EECS581Team15/WifiLMR/docs/basics/Glossary.md

Glossary
========

Acronyms
--------

* LMR - Land Mobile Radio
* PTT - Push-to-talk
* UI - User Interface

Terms
-----

* Subscriber Unit - The end user device (a.k.a. "radio" in common practice)
