EECS581Team15/WifiLMR/(threads)

Thread 2 (2018-10-08):

UI design

zjcers, 2018-10-08:
* Create mock ups for the various user interface screens.
   Make some pictures in Photoshop or GIMP as reference for when we're implementing the UI.
* Document user work flows
   Diagrams for how a user uses the UI (ex: for this task, press <button> to reach this screen, or select the given menu item)

jackdweber, 2018-10-17:
UI Designs needed
* Main Screen
* Settings / Applications screen
    * Possible theming
    * WiFi Selection?
    * Volumes
    * More to come
* Channel selection
* Messaging Screen
    * Messaging Detail Screen

zjcers, 2018-10-18:
Volume and channel selection will have hardware controls. We'll probably want a selection screen for channels either way, though. Might want a nice display slider to pop up when adjusting volume, too.

I think "zones" (groups of channels) were in the spec, so we'll probably want a list screen for that, too.

zjcers, 2018-10-22:
Note: the screen we selected has a resolution of 160x128.

AstralA, 2018-10-29:
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 Main Screen
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 Setting Screen
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 Channel Screen
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 Messages Screen
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 Zones Screen
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 User Workflow

Closed 2018-10-29.

Thread 3 (2018-10-08):

UI MVP

zjcers, 2018-10-08:
Implementation of the UI from #2. The implementation definitely needs to run on ARM GNU/Linux, but it would be really nice if the chosen toolkit library supports multiple platforms. It also needs to be .NET Core compatible because of our implementation choices. From these constraints, I recommend GTK#. It runs on Linux, Windows, and OS X (I believe). There's also a lot of examples for it. The only problem that see is that it rather heavy, but no more so than Qt.

zjcers, 2018-10-11:
@johnying7 You might want to look at this.

jackdweber, 2018-10-29:
see branch initial_ui

Thread 4 (2018-10-09):

Select initial hardware

zjcers, 2018-10-09:
* System on Module - [Raspberry Pi Zero W](https://www.adafruit.com/product/3400)
* Screen - [1.8 TFT ](https://www.adafruit.com/product/358)
* d-pad - either something pre-made or make a small PCB with push buttons (or https://www.adafruit.com/product/504)
* some sort of RGB led and driver circuit (could be an AVR like the ATtiny4313 driving PWMs)
* Battery
* Fuel guage/charging circuit

zjcers, 2018-10-28:
https://docs.google.com/spreadsheets/d/1XvdMbyRwS1jhkPt34Vz_26SZia36OKx0R4IcnpCc9fw/edit?usp=sharing

Closed 2018-10-28.

Thread 6 (2018-10-14):

Design HAL Interfaces

zjcers, 2018-10-14:
To facilitate development, we need to have a hardware abstraction layer that allows switching between interfacing with real hardware and simulated hardware. This will also ensure the hardware implementation details don't sink into unrelated components, like the UI.

zjcers, 2018-11-23:
HAL Interfaces:
* Backlight
   - set_level(lvl) (sets level to lvl, a value in [0, 100])
   - off() (sets level to 0 and saves previous)
   - on() (sets level to previous)
* Battery
   - get_level() (gets an estimated percentage in [0, 100])
   - is_charging() (returns True if the battery is charging)
* WiFi
   - scan() (returns a list of base stations in range)
   - connect(name, auth_data=None) (connect to a network)
   - status() (returns signal strength and other data)

zjcers, 2018-11-23:
This is probably good enough for now. I'll leave this open for a while for additional discussion.

zjcers, 2019-02-05:
After some more thought on this, it'd probably be simpler for wifi to just accept wpa_supplicant config files. This way we don't have to really worry too much about wifi, we can just let wpa_supplicant do all of the smart stuff.

We should probably think about providing a mechanism for rolling back a failed wifi config update ()

Closed 2019-04-22.

Thread 7 (2018-10-14):

Implement Dummy HAL

zjcers, 2018-10-14:
This HAL implementation will simulate (in a "best effort" sort of way) the actual hardware components of the radio. The biggest focus is on input and output, as the UI is the largest component we will have to build ourselves.

zjcers, 2018-10-14:
blocked by #6

zjcers, 2018-10-14:
Input and output can be implemented using standard Linux things:
Input: https://www.kernel.org/doc/Documentation/devicetree/bindings/input/gpio-keys.txt
Output: SPI framebuffer + http://www.microwindows.org/ to allow the use of "X11"

zjcers, 2018-11-23:
This is no longer blocked by #6 and is ready to be implemented.

zjcers, 2019-02-27:
The backlight implementation was done so that this isn't needed. I'd imaging wifi and battery will follow suit, so this issue is obsolete.

Closed 2019-02-27.

Thread 8 (2018-10-14):

Power switch circuit

zjcers, 2018-10-14:
Design constraints:
* Minimize power draw when device is off
* Allow soft power down (warn the OS rather than just cutting power)
* Minimize components

zjcers, 2018-10-15:
I've been looking into the RUN pin on the RPi (aka BCM2835 RESET). This looked viable, but the power draw in halt mode (this pin does not full shutdown the board) is rather high (15-30ma for the RPi alone). The simplest thing to do is control the main power supply through a MOSFET and build some logic so that the OS must acknowledge the shutdown request before power is cut.

I considered debouncing the power switch with a RC low pass filter plus a Schmitt trigger buffer. While that circuit is pretty simple, we need to handle the soft shutdown case as well. That is doable by using a Schmitt trigger input quad NOR gate. The buffer of the debouncer would be one half of an SR latch. This leaves the other half of the chip free to be used for handling the shutdown input (R for the latch). Unfortunately, there isn't a good way to tell that the RPi has finished its shutdown sequence. The only option is monitoring TXD, which would need buffered (to not corrupt the serial output) and debounced. Additionally, TXD is low at start up, its input should only take effect after the debounced power switch input goes low. This is solvable (I have schematic sketched in my notebook). On the other hand, there's a cheaper, easier solution: a very small microcontroller.

I believe the best option for this is the ATtiny4313. I considered using something really small, like the ATtiny9 (which is physically very, very small), but for a dime more, the 4313 offers enough PWM to implement not only power sequencing, but control of the RGB status LED. The ATtiny214 would have been an excellent choice, except there's not a whole lot of development resources on it right now (since it seems to be an AVR with some PIC peripherals glued on). Also, I have some 4313s on hand already.

With 3 channels of PWM in play + a timer driving the debounce routines, the implementation will be a little goofy. The 4313 has two timers: 1 8-bit timer and 1 16-bit timer. The 8-bit one will be setup to run PWM on both compare channels. The 16-bit timer will run PWM on one channel and drive the douncer ISR off of the other. Both will run at the PWM frequency. The PWM outputs will be exposed over I2C as 16-bit words of (output, level). The actual PWM functionality will not be implemented as part of this ticket.

zjcers, 2018-12-03:
The microcontroller was dropped completely. I also managed to get away with removing any sequential logic by replacing the power button with a switch.

I'm leaving this ticket open until the design is actually verified.

zjcers, 2019-03-21:
Cannot verify this until #16 is implemented.

Thread 10 (2018-10-15):

Screen hardware implementation - development board

zjcers, 2018-10-15:
Screen (Adafruit): https://www.adafruit.com/product/618

For the initial development, this will likely follow the tutorials listed on Adafruit. Since using the parallel interface would consume almost all available pins on the RPi, we'll have to use SPI. This will be somewhat less performant, but should be fine.

zjcers, 2019-02-13:
I've got this mostly working, but activating rotation (screen defaults to portrait) seems to break things. I need to investigate further. Changes will end up in #47

zjcers, 2019-02-16:
This is awaiting review

zjcers, 2019-02-21:
Closed by #47

Closed 2019-02-21.

Thread 9 (2018-10-15):

Platform Controller Firmware Implementation

zjcers, 2018-10-15:
As discussed in #8, the simplest way to implement the power switch will be to use a small microcontroller. The part is an ATtiny2313 or ATtiny4313, depending on code size (likely the 2313 will be sufficient). As discussed in #8, this controller should perform the following duties:
* Power switch debouncing
* Power on, power off sequencing - soft power down (don't cut main power until the main processor halts)
* PWM output to the RGB status LED

Note: I was considering using an ADC on this controller to read the volume potentiometer. There isn't a great reason to do this in our case (though it would give us more control). The 4313 doesn't have an ADC, so this isn't happening.

zjcers, 2018-12-04:
This ticket is now obsolete since the design now omits the platform controller

Closed 2018-12-04.

Thread 13 (2018-10-18):

Write a device tree overlay for D-pad input

zjcers, 2018-10-18:
The Linux kernel has a nice driver for mapping raw GPIOs into a keyboard-like device: https://www.kernel.org/doc/Documentation/devicetree/bindings/input/gpio-keys.txt. Our D-pad will have 5 inputs: KEY_UP, KEY_DOWN, KEY_LEFT, KEY_RIGHT, KEY_ENTER. These have pretty obvious mappings to normal Linux keys. There's also built-in debouncing, so we don't need to implement that either.

jackdweber, 2018-10-25:
http://blog.gegg.us/2017/01/setting-up-a-gpio-button-keyboard-on-a-raspberry-pi/

Obviously blocked until we have the device.

zjcers, 2019-03-21:
I've got this all but done in a local branch.

Closed 2019-04-22.

Thread 16 (2018-10-18):

Configure gpio-poweroff

zjcers, 2018-10-18:
The Linux kernel has a mechanism for triggering power down from a GPIO. In fact, the RPi kernel has a builtin dtoverlay for this: https://github.com/raspberrypi/linux/issues/1802. This is blocked by #8 and #9.

zjcers, 2019-03-21:
Blocked on #80

Thread 18 (2018-10-18):

BSP build system

zjcers, 2018-10-18:
The Board Support Package includes the kernel, bootloader, and root filesystem (which includes our application). There should be a relatively pain-free way to take our board support modifications along with our RadioApp and provisions to boot into it. The RPi already boots from SD cards, so "flashing" a unit should be relatively simple, though doing so on Windows will require some sort of raw image writing application.

zjcers, 2018-10-25:
Buildroot already has a working configuration for the RPi Zero W, so this shouldn't take long. On the other hand, I can't reasonably test this without real hardware, so I'm tabling this until we get hardware.

zjcers, 2018-11-23:
Going to introduce a branch with Buildroot set up. Since development hardware still isn't assembled (but will be soon), this will be a work in progress for a little while

Closed 2019-02-05.

Thread 23 (2018-10-26):

Acquire development hardware

zjcers, 2018-10-26:
Need to get:
 * Raspberry Pis (going to try to order all 10 of them)
 * Audio Hardware
   - Amplifier (digital) (breakout)
   - Microphone (digital) (breakout)
   - Speaker
 * Screen breakout
 * User controls
   - Navigation/D-pad
   - PTT
   - Channel knob
   - Volume knob
 * Power supply components (so far)
   - Power sequencer (ATtiny9)
   - Standby power supply (linear regulator 3.3v)
   - SOT23 breakout boards for ATtiny & regulator
   - MOSFET to cut main power
 * Solder breadboard to make prototypes semi-permanent

## Notes:
 * Only order 2 each of breakout boards and parts that aren't certain yet (speaker, switches)

zjcers, 2018-10-26:
There is an order summary in Gdrive under PartsOrders

zjcers, 2018-10-26:
Order submitted to Dr. Johnson for approval.

zjcers, 2018-11-23:
First order received and assembly underway. Will need to file a second order now that the schematic is done.

Closed 2018-11-23.

Thread 32 (2018-11-18):

Convert the UI to use keyboard input

zjcers, 2018-11-18:
The UI MVP uses mouse input for button presses. As we will not have a mouse or any other sort of pointing device, we need to convert it use keyboard navigation. Specifically, there will be five keys: up, down, right, left, and enter. This dictates that there will be a `current` selected control. This control should be highlighted in some way and pressing enter should activate it.

zjcers, 2018-12-04:
tkinter already supports Tab and Shift+Tab for navigation and Space for activating controls. We can map the left, right, and select keys to those event types and this should mostly work. One thing I noticed is that widgets that are from the previous screen are still accessible. This is another issue that should be addressed anyway.

zjcers, 2019-03-07:
Stealing this.

Closed 2019-03-09.

Thread 33 (2018-11-18):

Initial mechanical design

zjcers, 2018-11-18:
A rough version of the casing of the device along with its buttons should be created. A good deal of the internal structure can be started as well such as the mounts for the speaker and back cover. The battery holder can be started once a battery is selected so long as the placement does not depend on the layout of the expansion PCB. Since the expansion PCB is not completed yet, the mounting points for it may not be possible.

zjcers, 2018-12-04:
I've had this mostly completed for a while. It's missing the mounting points for the PCB (which are now known as the initial layout is nearly complete).

zjcers, 2019-02-05:
I'm going to put up a PR for this. It's not perfect (it's missing the top controls and the PCB standoffs are all wrong) but that way it makes it into source control

Closed 2019-03-16.

Thread 34 (2018-11-18):

Provisioning mode UI

zjcers, 2018-11-18:
The provision mode flow is documented in docs/features/ProvisioningMode.md. As of right now, this document is out of date if we're aiming to use WiFi Protected Setup, though we may want to revisit that issue seeing as though most enterprise WiFi deployments do not support WPS. As such, the ticket is pending that discussion.

Thread 50 (2019-02-13):

Battery gauge should be an icon

zjcers, 2019-02-13:
The battery meter should be an icon that "fills up" with charge, like on most phones/portable devices.  Extra points if it changes color at certain percentages (say, red at < 20%, orange at < 40%, green otherwise).

zjcers, 2019-03-07:
Since tkinter makes it hard to draw redraw graphics, how about an outlined rectangle with a colored background (which turns red on low battery) with the percentage text centered inside of it?

AstralA, 2019-03-07:
Yes, I'm trying to build it that way.

Closed 2019-04-05.

Thread 51 (2019-02-13):

Bottom buttons should have images for labels

zjcers, 2019-02-13:
Right now the on-screen buttons have the numbers 1, 2, and 3 for labels. These should be replaced with icons, like in @jackdweber 's UI mock up.

Closed 2019-03-16.

Thread 52 (2019-02-13):

Main Menu UI

zjcers, 2019-02-13:
Since we're going to have more screens than can fit on the 3 main screen buttons, we need some sort of menu in which less-frequently used items can be accessed. This can either be a simple list of items (a ListView in most UI paradigms) or an array of icons (like most flip phones).

Thread 59 (2019-02-13):

Low-level backlight support

zjcers, 2019-02-13:
In order for the backlight UI to have effect we need to:
- [x] Map the backlight PWM in device tree
- [x] Expose the PWM device through the HAL
- [x] Hook the UI up to the HAL

zjcers, 2019-02-27:
Pending review

Closed 2019-03-07.

Thread 71 (2019-03-14):

Reconfigure display driver for PCB use

zjcers, 2019-03-14:
The PCB design doesn't match the default mapping the display driver assumes. The correct mapping is:
* LCD_RESET -> GPIO24
* LCD_DC -> GPIO7
* LCD_CS -> GPIO8
* BKLIGHT -> GPIO12 (already mapped)

Closed 2019-03-16.

Thread 73 (2019-03-16):

RPi connector is backwards

zjcers, 2019-03-16:
The PCB layout originally had the RPi connector (J5) on the other edge of the board. When it got moved, it should have been rotated 180 degrees to compensate. Currently, the RPi sticks out from behind the main board rather than being tucked behind as intended.

Thread 74 (2019-03-16):

Screen connector is backwards

zjcers, 2019-03-16:
This is similar to #73. The screen footprint needs to be rotated 180 degrees so that the screen pinout matches up correctly. This will require moving the pads from the left edge to the right edge as well (but there's plenty of extra space available).

zjcers, 2019-04-04:
Correction: It was not 180 degrees, it was due to the footprint having the pads on the wrong side of the board. It can still be fixed by rotating 180 degrees, though the layout might be nicer if the actual footprint is fixed (otherwise the screen connector ends up very close to J5).

Thread 75 (2019-03-16):

Audio amplifier layout is wrong

zjcers, 2019-03-16:
The following corrections should be made to make the device function:
* GAIN_SLOT should be connected with a 100k resistor to Vcc (to set gain at 3dB to avoid overloading the power supply)
* The NC pads should actually be no-connects. Duh.

Currently the device outputs a somewhat modulated PWM signal (mostly correct) but the gain is set so stupidly high (12 dB) that the output just clips pretty much constantly.

zjcers, 2019-03-21:
Strictly speaking, this wasn't just a layout issue since the schematic was wrong as well.

Thread 76 (2019-03-16):

Charging connector is missing

zjcers, 2019-03-16:
The first revision of the PCB is conspicuously missing a way to apply power. As a workaround, I've been supplying power via test points on the RPi.

Thread 77 (2019-03-16):

Audio driver support

zjcers, 2019-03-16:
Need to map the MAX98357A I2S DAC/amp and the SPH0645LM4H I2S microphone. The main constraint is that the microphone needs BLCK=LRCLK/64. Luckily, the DAC is more flexible, so the two can coexist. Unfortunately, this will require a custom device tree overlay (as opposed to invoking one of the premade ones).

zjcers, 2019-03-21:
Using a combination of `simple-audio-card` and the standard SPDIF drivers, I was able to get the amplifier to work. As far as I can tell, the SPDIF codec drivers don't support 32-bit sampling (required by the microphone), so a custom codec driver will need to be implemented.

Closed 2019-04-22.

Thread 78 (2019-03-18):

I2C lines on J5 are reversed

zjcers, 2019-03-18:
I don't know how this got managed, but SCL is connected to SDA and vice-versa.

zjcers, 2019-03-21:
This was a transposition on the schematic.

Thread 80 (2019-03-21):

Shutdown/reboot is broken

zjcers, 2019-03-21:
The current kernel configuration fails to halt the system with something along the lines of "Failed to reboot; halting system"

Thread 83 (2019-03-27):

Mechanical design v2

zjcers, 2019-03-27:
**Bugs in v1**
- [x] Walls were thicker than necessary
- [x] Buttons were too close together (skirts conflicted with each other)

**Missing features in v1**
- [x] Mounts for PTT button
- [x] Mounts & cut outs for knobs & encoders
- [x] Version label on inside of front
- [x] Mounts for speaker
- [x] Internal stabilizers for screen
- [ ] Mounts for rear cover

**Design changes since v1**
- [x] PCB mounts have changed
- [x] Can be narrower
- [x] Mounting screws can go straight into plastic rather than using the thermal insets

Closed 2019-04-04.

Thread 88 (2019-04-10):

Op-amp U2 not driven into saturation

zjcers, 2019-04-10:
Since the inputs to U2 (BATT+ and +5V) are higher than its Vcc, it is not driven into saturation. Kludging voltage dividers (100k/10k) onto the inputs fixed this.

Thread 89 (2019-04-10):

Mechanical design v4

zjcers, 2019-04-10:
The v3 casing is mostly okay except for the following issues:

- [x] Not wide enough to fit battery in
- [x] Side PTT will not be used
- [x] Knobs should have skirts
- [x] Button holes need to shrink by 0.1 mm (center) and 0.075mm (others)

Closed 2019-04-22.

Thread 90 (2019-04-17):

Microphone (U9) footprint is backwards

zjcers, 2019-04-17:
Needs flipped over the long axis of the part.
