EECS581Team15/WifiLMR/hardware/electronic/LMRHAT.kicad_pcb

## KiCad design hardware/electronic/LMRHAT.kicad_pcb (2019-02-05)

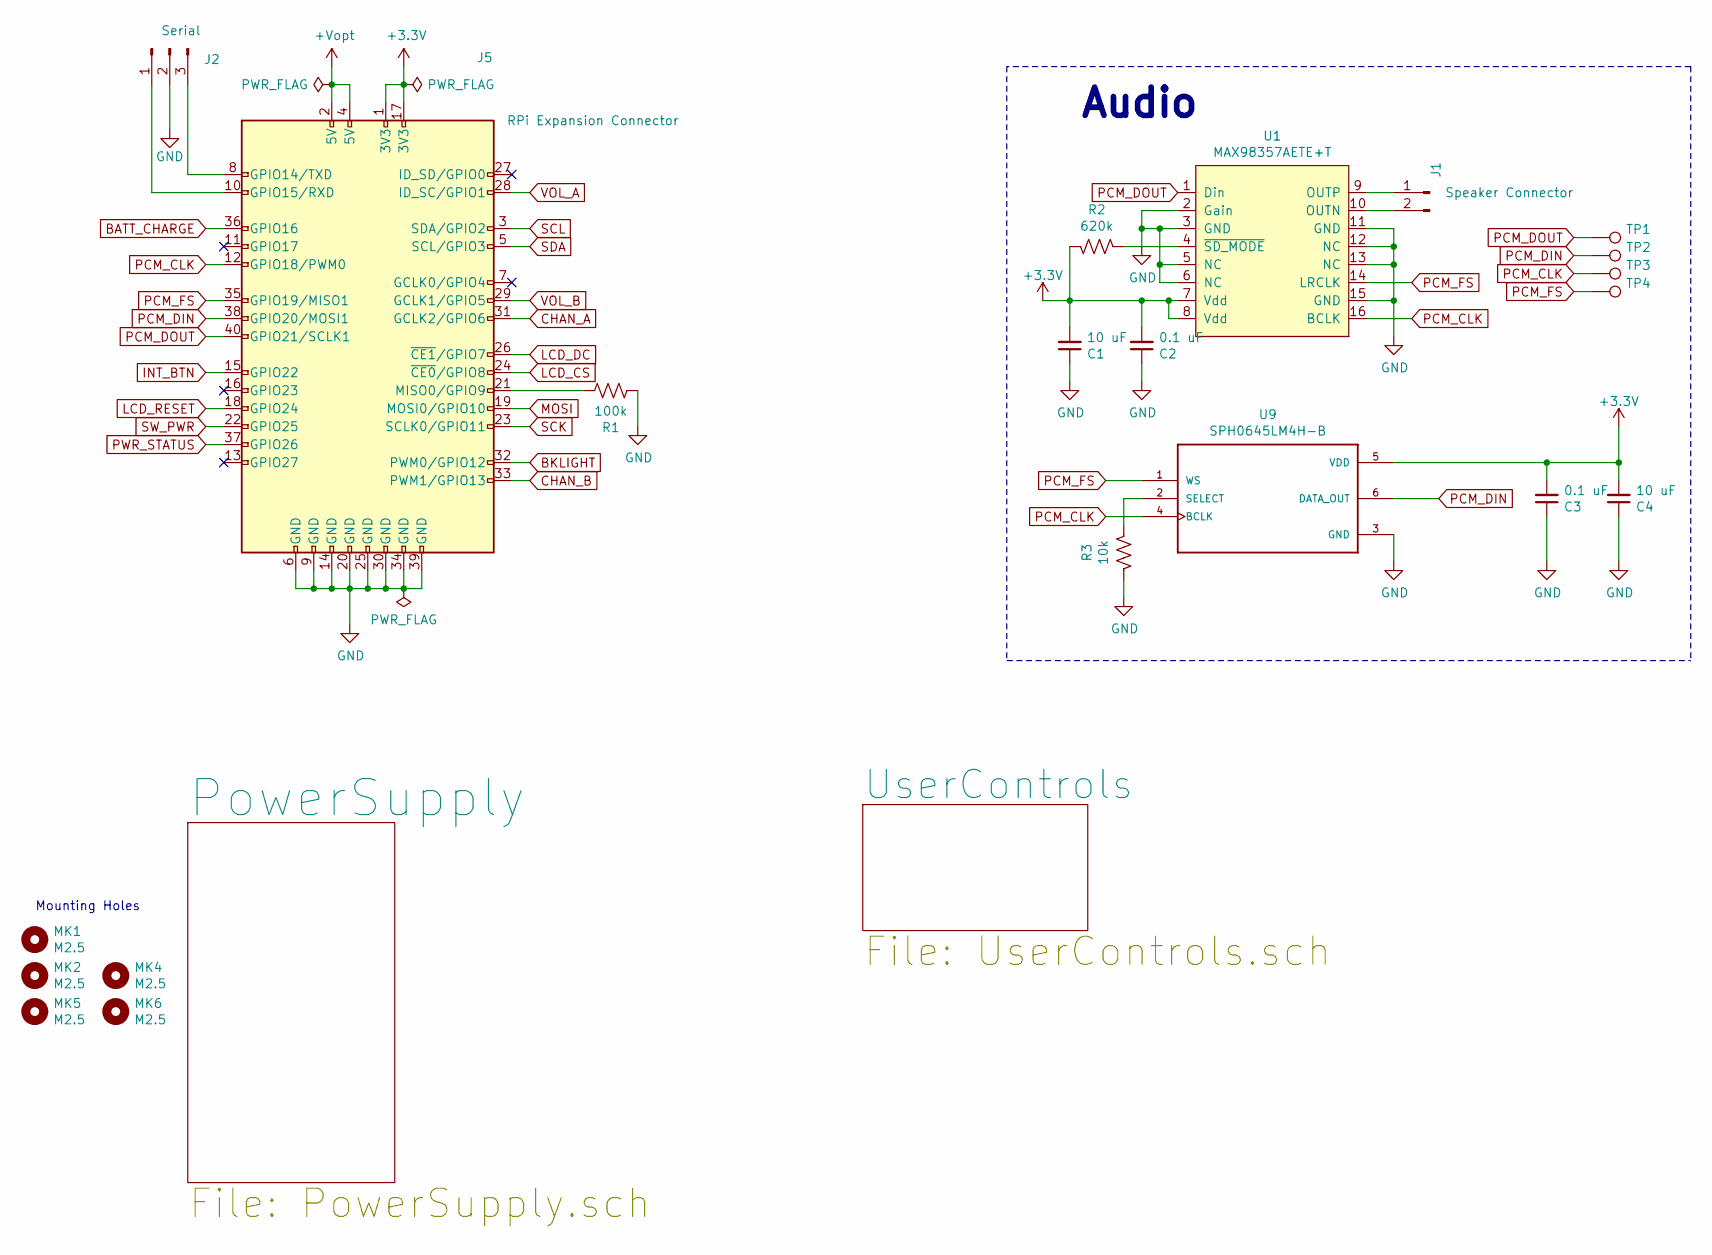
[picture p1: schematic LMRHAT.sch]

Parts:
C1, C4: 10 uF; C_1206_3216Metric_Pad1.42x1.75mm_HandSolder
C2, C3: 0.1 uF; C_1206_3216Metric_Pad1.42x1.75mm_HandSolder
J1: Speaker Connector; JST_EH_B02B-EH-A_1x02_P2.50mm_Vertical
J2: Serial; PinSocket_1x03_P2.54mm_Vertical
J5: RPi Expansion Connector; PinSocket_2x20_P2.54mm_Vertical_SMD
MK1, MK2, MK4, MK5, MK6: M2.5; MountingHole_2.7mm_M2.5
R1: 100k; R_1206_3216Metric_Pad1.42x1.75mm_HandSolder
R2: 620k; R_1206_3216Metric_Pad1.42x1.75mm_HandSolder
R3: 10k; R_1206_3216Metric_Pad1.42x1.75mm_HandSolder
TP1, TP2, TP3, TP4: TestPoint_Pad_D1.0mm
U1: MAX98357AETE+T; QFN-16-1EP_3x3mm_P0.5mm_EP1.8x1.8mm
U9: SPH0645LM4H-B; MIC_SPH0645LM4H-B

Connections:
+3V3: C1.2, C2.2, C3.2, C4.2, J5.1 (3V3), J5.17 (3V3), R2.1, U1.7 (Vdd), U1.8 (Vdd), U9.5 (VDD); also elsewhere on the board
+5V: J5.2 (5V), J5.4 (5V); also elsewhere on the board
BATT_CHARGE: J5.36 (GPIO16); also elsewhere on the board
BKLIGHT: J5.32 (PWM0/GPIO12); also elsewhere on the board
CHAN_A: J5.31 (GCLK2/GPIO6); also elsewhere on the board
CHAN_B: J5.33 (PWM1/GPIO13); also elsewhere on the board
INT_BTN: J5.15 (GPIO22); also elsewhere on the board
LCD_CS: J5.24 (~CE0~/GPIO8); also elsewhere on the board
LCD_DC: J5.26 (~CE1~/GPIO7); also elsewhere on the board
LCD_RESET: J5.18 (GPIO24); also elsewhere on the board
MOSI: J5.19 (MOSI0/GPIO10); also elsewhere on the board
unnamed: J1.1, U1.9 (OUTP)
unnamed: J1.2, U1.10 (OUTN)
unnamed: J2.1, J5.10 (GPIO15/RXD)
unnamed: J2.3, J5.8 (GPIO14/TXD)
unnamed: J5.21 (MISO0/GPIO9), R1.1
unnamed: R3.2, U9.2 (SELECT)
PCM_CLK: J5.12 (GPIO18/PWM0), TP3.1, U1.16 (BCLK), U9.4 (BCLK)
PCM_DIN: J5.38 (GPIO20/MOSI1), TP2.1, U9.6 (DATA_OUT)
PCM_DOUT: J5.40 (GPIO21/SCLK1), TP1.1, U1.1 (Din)
PCM_FS: J5.35 (GPIO19/MISO1), TP4.1, U1.14 (LRCLK), U9.1 (WS)
PWR_STATUS: J5.37 (GPIO26); also elsewhere on the board
SCK: J5.23 (SCLK0/GPIO11); also elsewhere on the board
SCL: J5.3 (SDA/GPIO2); also elsewhere on the board
SDA: J5.5 (SCL/GPIO3); also elsewhere on the board
SW_PWR: J5.22 (GPIO25); also elsewhere on the board
VOL_A: J5.28 (ID_SC/GPIO1); also elsewhere on the board
VOL_B: J5.29 (GCLK1/GPIO5); also elsewhere on the board

Notes on the sheet:
Mounting Holes
Audio

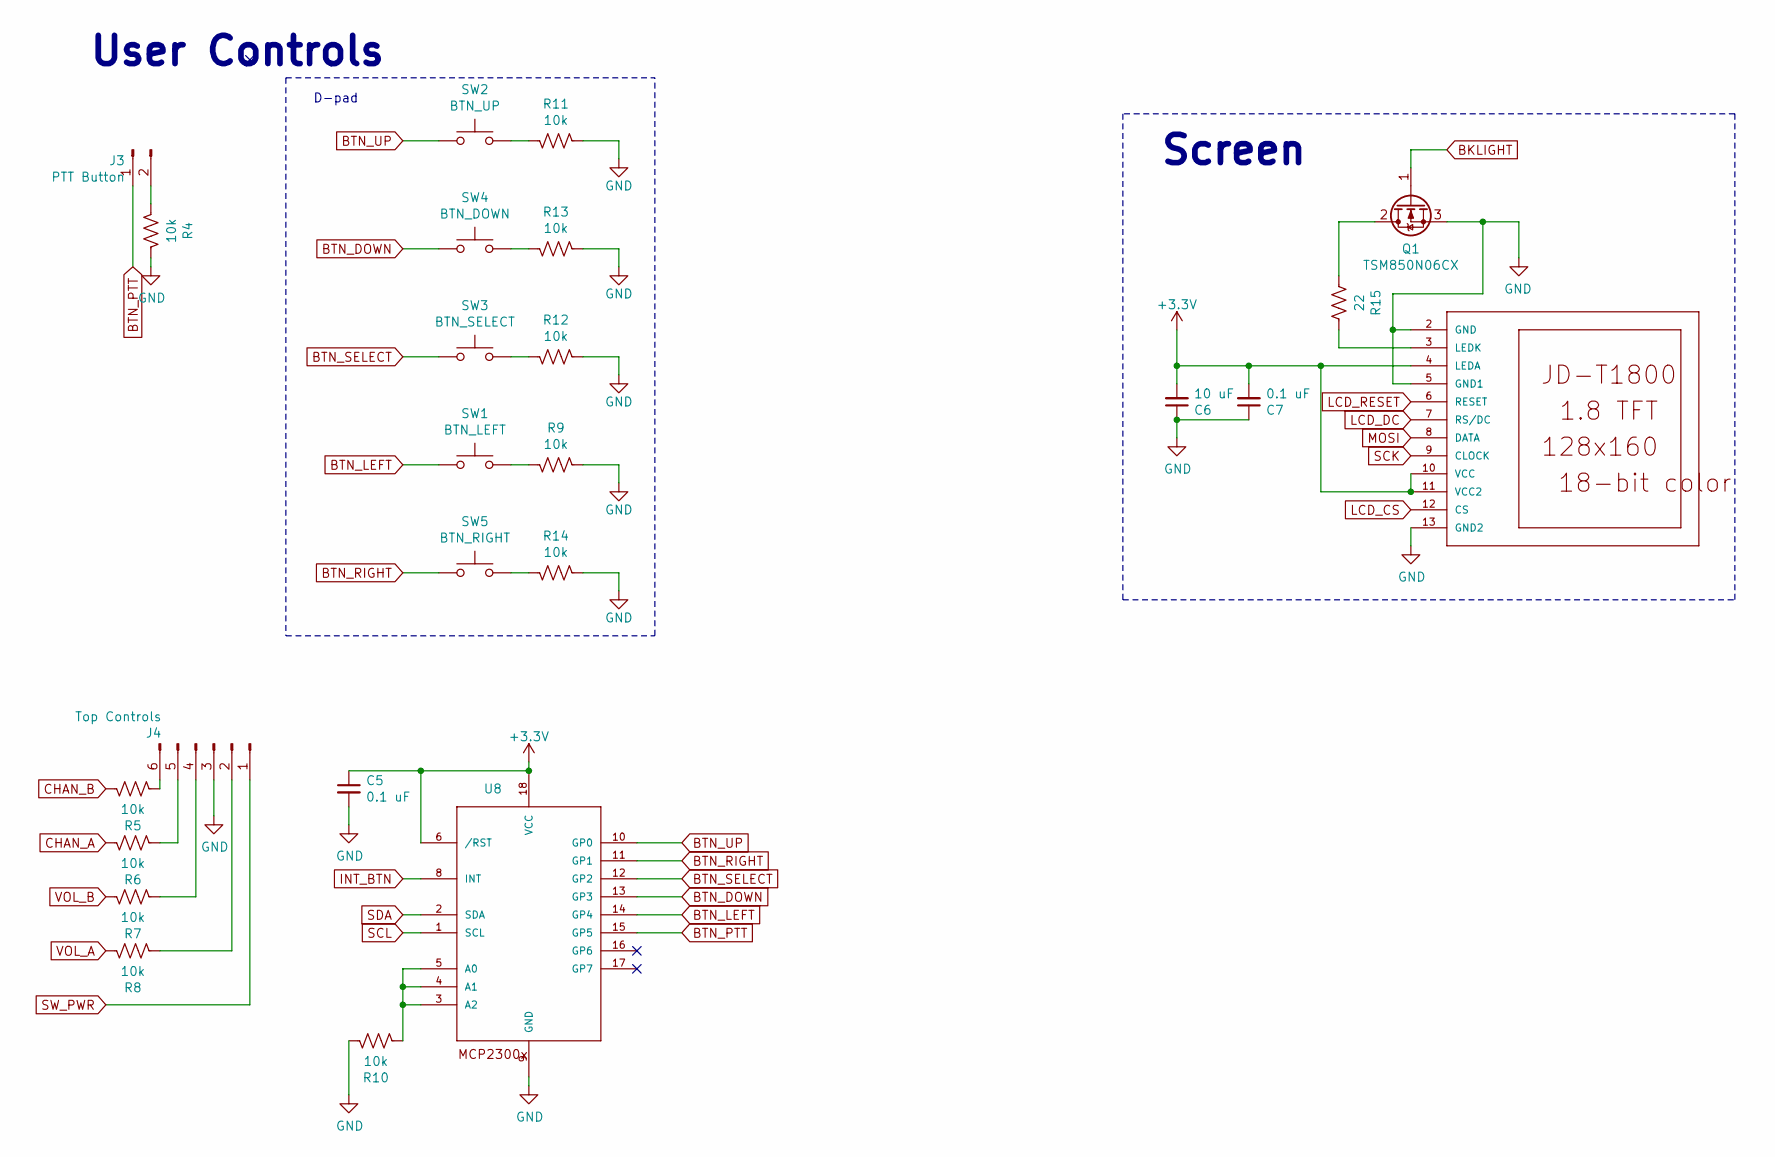
[picture p2: schematic UserControls.sch]

Parts:
C5, C7: 0.1 uF; C_1206_3216Metric_Pad1.42x1.75mm_HandSolder
C6: 10 uF; C_1206_3216Metric_Pad1.42x1.75mm_HandSolder
J3: PTT Button; JST_EH_B02B-EH-A_1x02_P2.50mm_Vertical
J4: Top Controls; PinHeader_2x03_P2.54mm_Vertical
LCD1: JD-T1800
Q1: TSM850N06CX; SOT-23_Handsoldering
R4, R5, R6, R7, R8, R9, R10, R11, R12, R13, R14: 10k; R_1206_3216Metric_Pad1.42x1.75mm_HandSolder
R15: 22; R_1206_3216Metric_Pad1.42x1.75mm_HandSolder
SW1: BTN_LEFT; SW_PUSH_6mm_H5mm
SW2: BTN_UP; SW_PUSH_6mm_H5mm
SW3: BTN_SELECT; SW_PUSH_6mm_H5mm
SW4: BTN_DOWN; SW_PUSH_6mm_H5mm
SW5: BTN_RIGHT; SW_PUSH_6mm_H5mm
U8: MCP23008_SO; SOIC-18W_7.5x11.6mm_P1.27mm

Connections:
+3V3: C5.1, C6.2, C7.2, LCD1.4 (LEDA), LCD1.10 (VCC), LCD1.11 (VCC2), U8.6 (/RST), U8.18 (VCC); also elsewhere on the board
BKLIGHT: Q1.1 (G); also elsewhere on the board
BTN_DOWN: SW4.1, U8.13 (GP3)
BTN_LEFT: SW1.1, U8.14 (GP4)
BTN_PTT: J3.1, U8.15 (GP5)
BTN_RIGHT: SW5.1, U8.11 (GP1)
BTN_SELECT: SW3.1, U8.12 (GP2)
BTN_UP: SW2.1, U8.10 (GP0)
CHAN_A: R6.2; also elsewhere on the board
CHAN_B: R5.2; also elsewhere on the board
INT_BTN: U8.8 (INT); also elsewhere on the board
LCD_CS: LCD1.12 (CS); also elsewhere on the board
LCD_DC: LCD1.7 (RS/DC); also elsewhere on the board
LCD_RESET: LCD1.6 (RESET); also elsewhere on the board
MOSI: LCD1.8 (DATA); also elsewhere on the board
unnamed: J3.2, R4.1
unnamed: J4.2, R8.1
unnamed: J4.4, R7.1
unnamed: J4.5, R6.1
unnamed: J4.6, R5.1
unnamed: LCD1.3 (LEDK), R15.1
unnamed: Q1.2 (D), R15.2
unnamed: R9.1, SW1.2
unnamed: R10.1, U8.3 (A2), U8.4 (A1), U8.5 (A0)
unnamed: R11.1, SW2.2
unnamed: R12.1, SW3.2
unnamed: R13.1, SW4.2
unnamed: R14.1, SW5.2
SCK: LCD1.9 (CLOCK); also elsewhere on the board
SCL: U8.1 (SCL); also elsewhere on the board
SDA: U8.2 (SDA); also elsewhere on the board
SW_PWR: J4.1; also elsewhere on the board
VOL_A: R8.2; also elsewhere on the board
VOL_B: R7.2; also elsewhere on the board

Notes on the sheet:
D-pad
User Controls
Screen

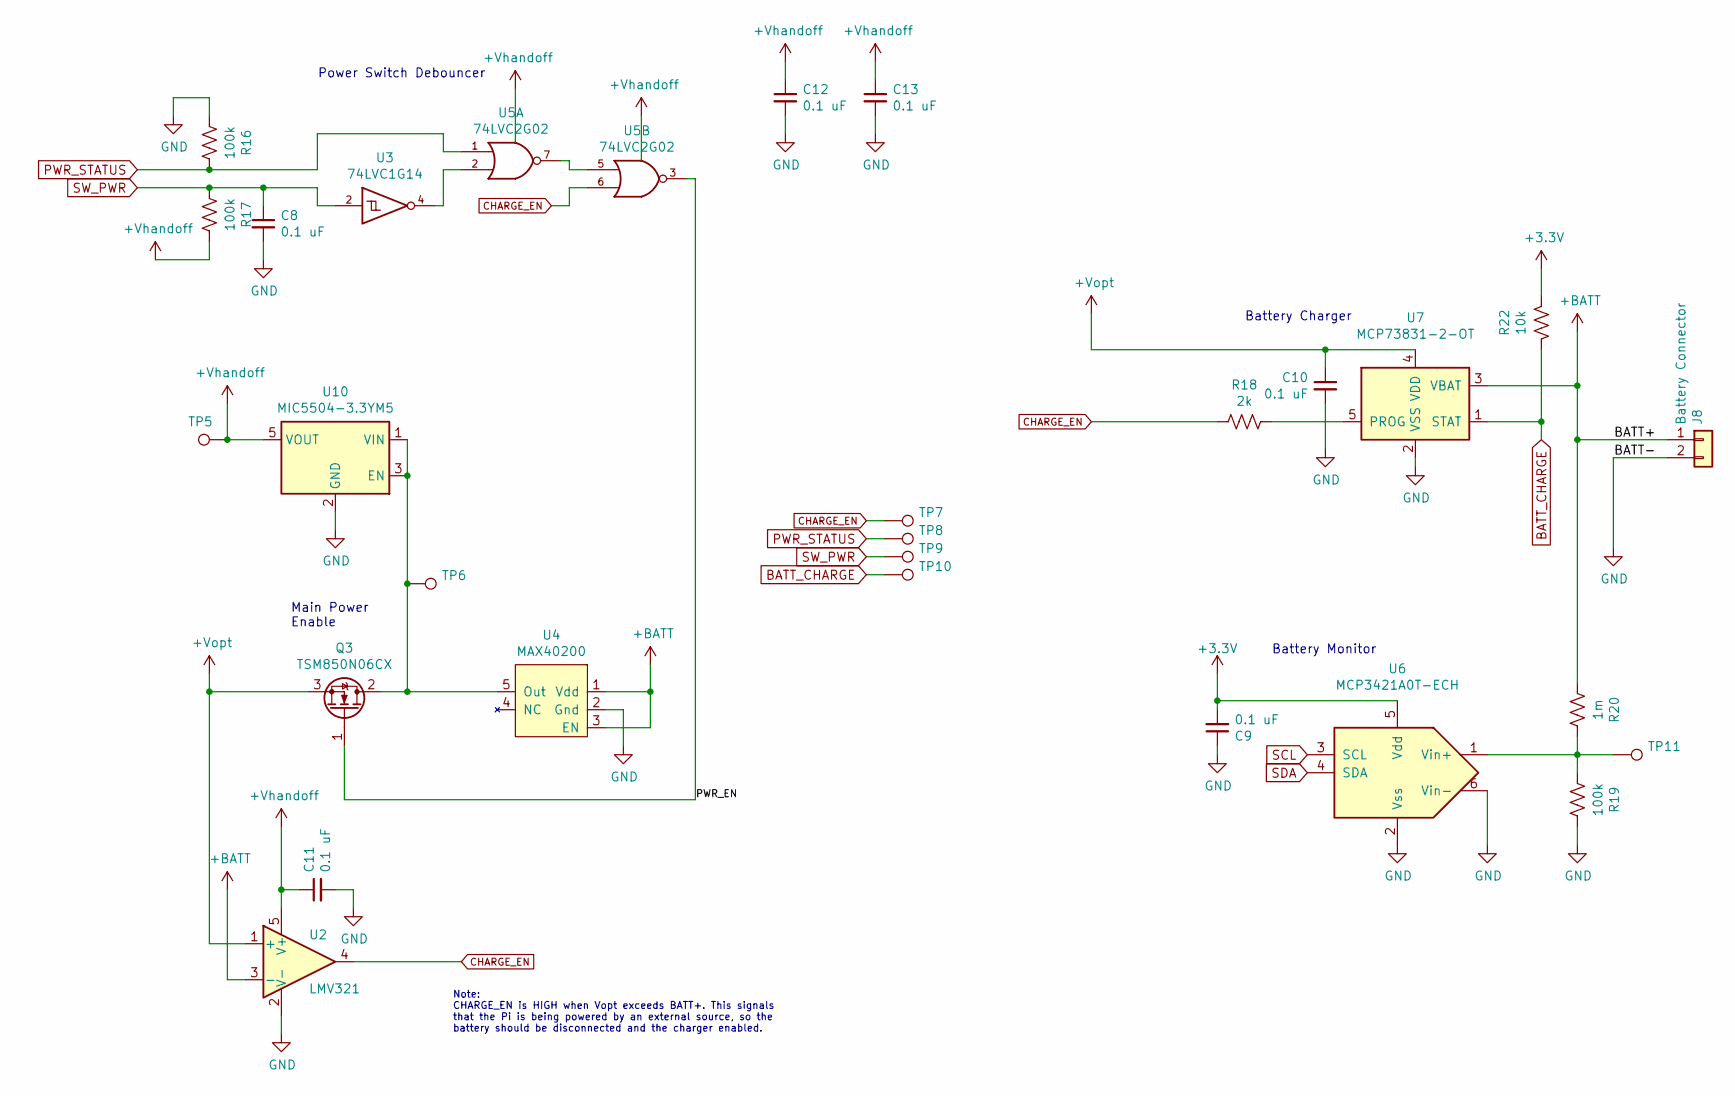
[picture p3: schematic PowerSupply.sch]

Parts:
C8, C9, C10, C11, C12, C13: 0.1 uF; C_1206_3216Metric_Pad1.42x1.75mm_HandSolder
J8: Battery Connector; JST_EH_B02B-EH-A_1x02_P2.50mm_Vertical
Q3: TSM850N06CX; SOT-23_Handsoldering
R16, R17, R19: 100k; R_1206_3216Metric_Pad1.42x1.75mm_HandSolder
R18: 2k; R_1206_3216Metric_Pad1.42x1.75mm_HandSolder
R20: 1m; R_1206_3216Metric_Pad1.42x1.75mm_HandSolder
R22: 10k; R_1206_3216Metric_Pad1.42x1.75mm_HandSolder
TP5, TP6, TP7, TP8, TP9, TP10, TP11: TestPoint_Pad_D1.0mm
U2: LMV321; SOT-23-5_HandSoldering; Digikey 497-13051-1-ND
U3: 74LVC1G14; SOT-353_SC-70-5_Handsoldering; Digikey 74LVC1G14SE-7CT-ND
U4: MAX40200; SOT-23-5_HandSoldering
U5: 74LVC2G02; TSSOP-8_3x3mm_P0.65mm
U6: MCP3421A0T-ECH; SOT-23-6_Handsoldering
U7: MCP73831-2-OT; SOT-23-5_HandSoldering
U10: MIC5504-3.3YM5; SOT-23-5_HandSoldering

Connections:
+3V3: C9.2, R22.2, U6.5 (Vdd); also elsewhere on the board
+5V: C10.1, Q3.3 (S), U2.1 (+), U7.4 (VDD); also elsewhere on the board
+BATT: J8.1, R20.2, U2.3 (-), U4.1 (Vdd), U4.3 (EN), U7.3 (VBAT)
+handoff: C11.1, C12.1, C13.1, R17.1, TP5.1, U2.5 (V+), U3.5 (VCC), U5.8 (VCC), U10.5 (VOUT)
/PowerSupply/PWR_EN: Q3.1 (G), U5.3
BATT_CHARGE: R22.1, TP10.1, U7.1 (STAT); also elsewhere on the board
CHARGE_EN: R18.2, TP7.1, U2.4, U5.6
unnamed: Q3.2 (D), TP6.1, U4.5 (Out), U10.1 (VIN), U10.3 (EN)
unnamed: R18.1, U7.5 (PROG)
unnamed: R19.2, R20.1, TP11.1, U6.1 (Vin+)
unnamed: U3.4, U5.2
unnamed: U5.5, U5.7
PWR_STATUS: R16.1, TP8.1, U5.1; also elsewhere on the board
SCL: U6.3 (SCL); also elsewhere on the board
SDA: U6.4 (SDA); also elsewhere on the board
SW_PWR: C8.1, R17.2, TP9.1, U3.2; also elsewhere on the board

Notes on the sheet:
Battery Charger
Battery Monitor
Main Power Enable
Power Switch Debouncer
Note: CHARGE_EN is HIGH when Vopt exceeds BATT+. This signals that the Pi is being powered by an external source, so the battery should be disconnected and the charger enabled.

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
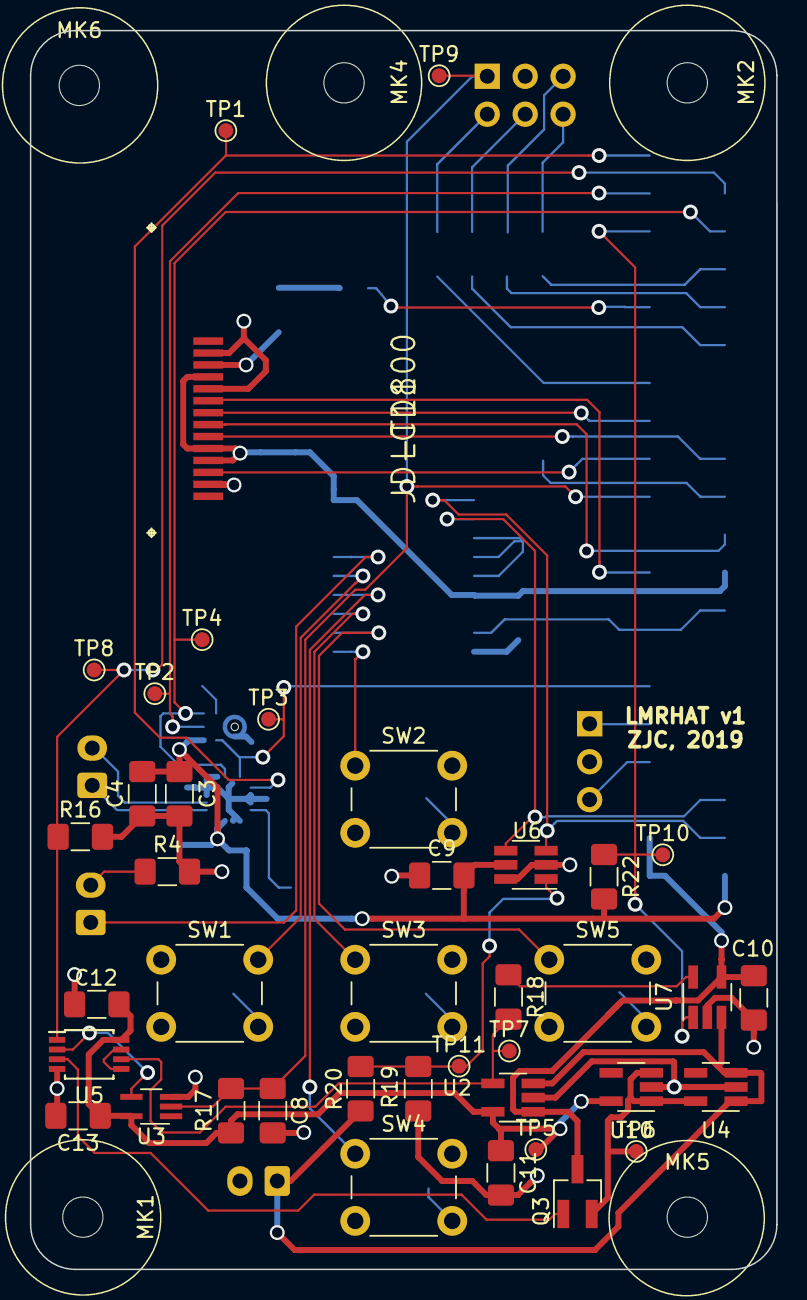
[picture p4: board LMRHAT.kicad_pcb from above]

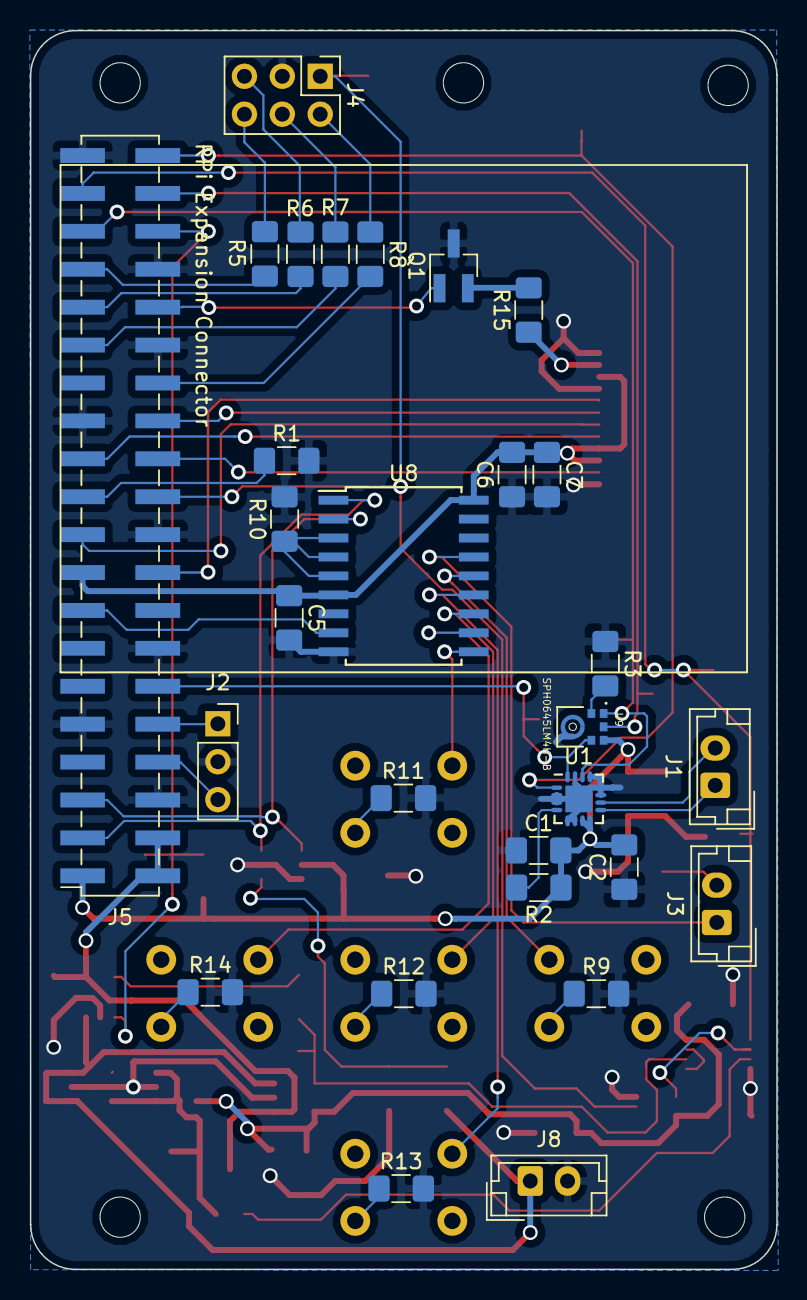
[picture p5: board LMRHAT.kicad_pcb from below]

Board: 2 copper layers, 50.0 x 83.0 mm, 74 parts (29 on the bottom side), 58 nets.
