EECS581Team15/WifiLMR/boardsupport/bsp/configs/config.txt

kernel=zImage
gpu_mem_256=100
gpu_mem_512=100
gpu_mem_1024=100
dtparam=spi=on
dtoverlay=pwm
dtoverlay=disable-p3-bt
