EECS581Team15/WifiLMR/(commit log)

2018-10-11 #1: Added note about status led
2018-11-12 #27: Added Device DB model
2018-11-28 #18: Added a BR2_EXTERNAL directory for our board
2018-11-30 #39: Switched to our own copy of buildroot
2018-12-03 Added Kicad gitignore from Github
2018-12-03 Added library of modified footprints
2018-12-03 Added initial schematic and PCB designs
    [LMRHAT.kicad_pcb, LMRHAT.sch, PowerSupply.sch, UserControls.sch]
2018-12-03 Connected power switch to a GPIO and moved the layout for readability
    [LMRHAT.kicad_pcb, LMRHAT.sch]
2019-01-27 Rescued schematic symbols since LMRHAT.lib didn't get saved
    [LMRHAT.sch, PowerSupply.sch, UserControls.sch]
2019-02-05 Updated layout and schematic to match board dimensions of 50x80mm
    [LMRHAT.kicad_pcb, LMRHAT.sch, PowerSupply.sch, UserControls.sch]
2019-02-05 #33: Added initial OpenSCAD casing design.
    [body.scad]
2019-02-06 Updated Button Size
2019-02-13 #39: Converted SPI master from module to builtin
2019-02-13 #39: Updated buildroot tree to enable SPI in device tree
2019-02-14 #39: Overrode xorg.conf to use the SPI display FB
2019-02-21 #59: Added custom RPi firmware config.txt with PWM enabled
    [config.txt]
2019-02-27 #59: Added pwm driver load to radioapp init script
2019-02-27 #59: Fixed various issues in radioapp backlight driver
2019-03-07 Added Button Icons
2019-03-14 #19: Disabled the bluetooth to renable serial console
    [config.txt]
2019-03-14 #19: Load the wifi driver before radioapp
2019-03-16 #77: Initial device tree overlay with playback support
2019-03-17 Thread that gets input sound
2019-03-18 #77: Attempted to force sample rate to 48000
2019-03-29 Battery Icon Added
2019-04-03 DBus now works correctly. Connected devices listed
2019-04-04 #77: Converted all device tree overlays to patches
2019-04-17 #77: Hacked the spdif Linux drivers to only support the rate and format we want
